jeehong/glow-tube-clock/datasheet/辉光管显示在八字节示意图.jpg

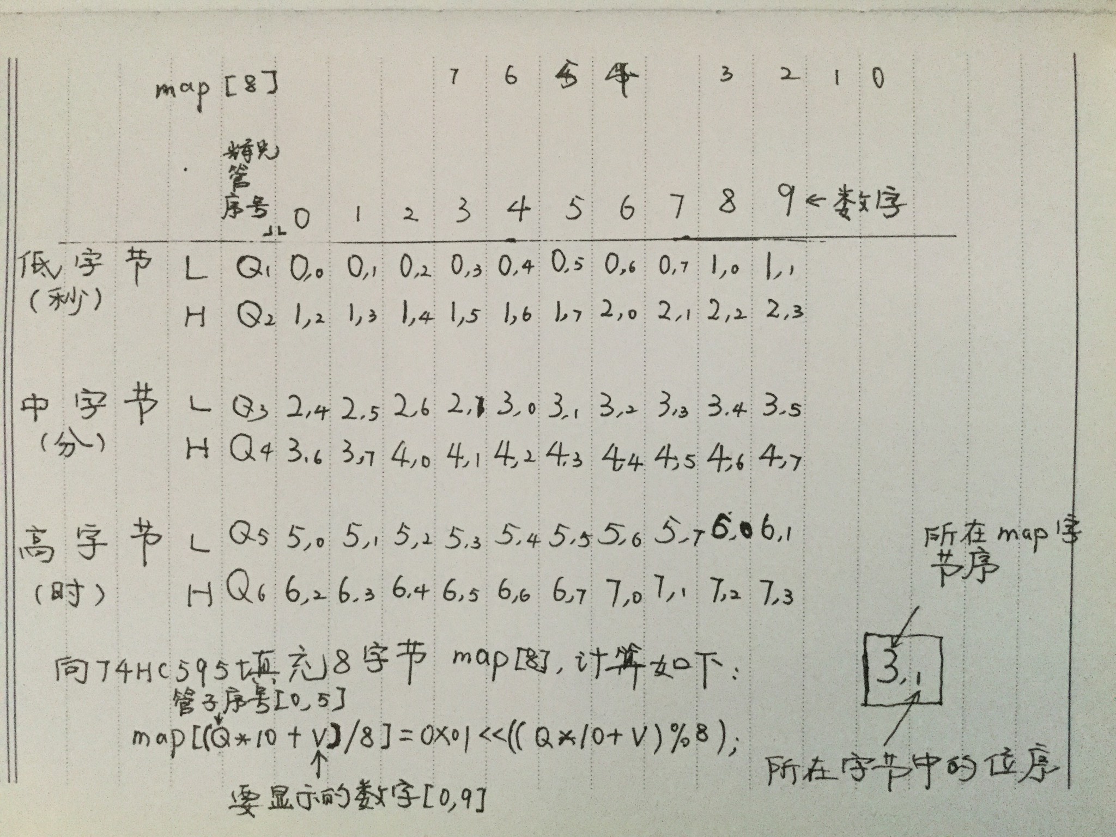
datasheet/辉光管显示在八字节示意图.jpg
