jeehong/glow-tube-clock/datasheet/in4.jpg

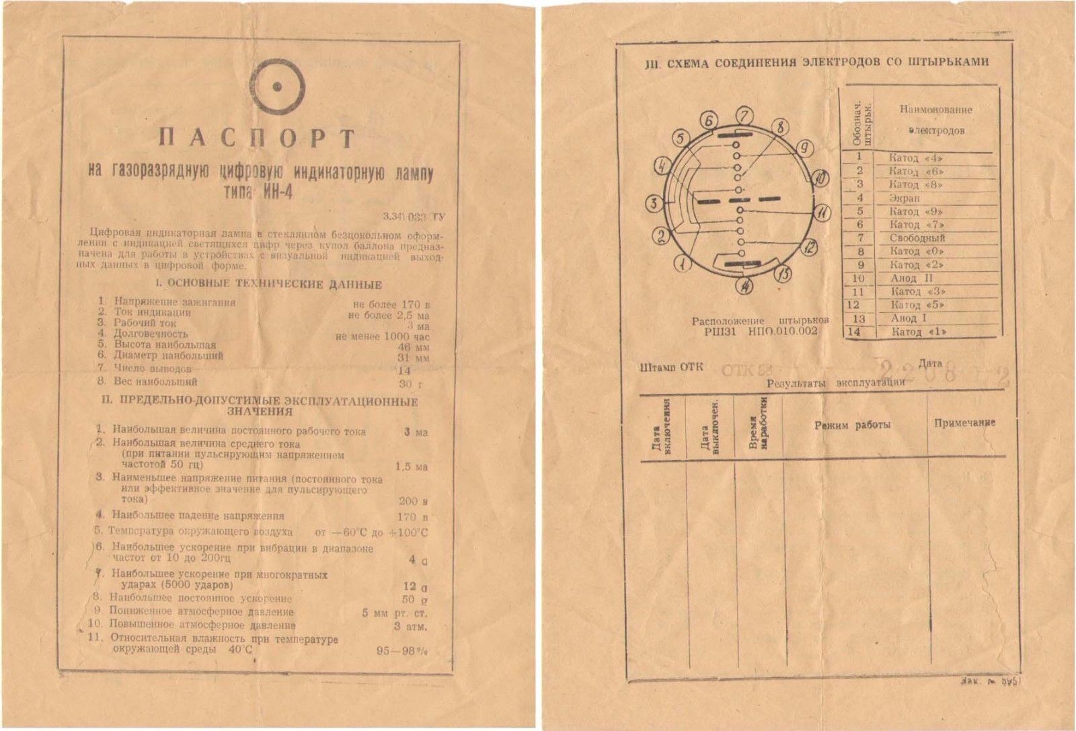
datasheet/in4.jpg
