jeehong/glow-tube-clock/README.md

----------
# **辉光管实时时钟** #

## 介绍 ##
 <p>辉光管亦称“冷阴极离子管”或“冷阴极充电管”，利用气体辉光放电原理而工作的离子管。。玻璃管中包括一个金属丝网制成的阳极和多个阴极。大部分数码管阴极的形状为数字。管中充以低压气体，通常大部分为氖加上一些汞和／或氩。给某一个阴极充电，数码管就会发出颜色光，视乎管内的气体而定，一般都是橙色或绿色。</p>
 <p>此次的diy项目就是利用辉光管的数显效果来做的，CPU采用STM32F103RCT6、软件搭载FreeRTOS实时系统、暂定使用LwIP协议栈，功能暂定温湿度显示日月年时分秒显示，网络校时网络获取当前温湿度的主体功能后续再考虑其他更有趣的功能。</p>

## 目录结构 ##
- datasheet:存放了器件原理图、构造、封装图等开发资料
- hardware:硬件工程，包含了原理图PCB图，器件原理图库、封装库
- software:软件工程，基于FreeRTOS、LwIP网络协议栈等

## 硬件 ##
- 开发环境：Altium Designer10
- STM32F103RCT6、DM9000、SHT10、DS3231SN、...

## 软件 ##
- 开发环境：Keil5
- 操作系统：FreeRTOS
- 网络协议栈：LwIP

## 项目进展 ##
请跳转至个人博客：[Jeehong's blog](https://jeehong.github.io/blog/2016/04/project-glow-tube-clock.html)

----------
