jeehong/glow-tube-clock/datasheet/in-4.jpg

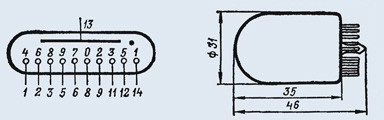
datasheet/in-4.jpg
