jeehong/glow-tube-clock/(threads)

Thread 1 (2018-11-09):

当前原理图下，存在几个已知的问题：

jeehong, 2018-11-09:
1、蜂鸣器不响问题：该问题实际电路制作时将PA12（原电路）与相邻的PA11(PWM)短接，软件上将PA12设置为输入模式，利用PA11的PWM功能模拟驱动蜂鸣器；
2、驱动辉光管的三极管为8050无法正常驱动，实际电路制作使用的9013；
3、目前为止，以太网功能没有调通；
4、高压驱动电路存在问题，实际电路制作购买的网上成熟的升压电路模块；
备注：
* 关于问题1、2会更新到github。
* 问题3找了好久问题，最后也没定位是硬件还是软件问题。我有一块类似的工程板（运行良好），软硬件都是基于此参考设计，硬件选型和布板差异，所以我比较倾向硬件出现问题。
* 问题4因为整个升压电路设计存在较大问题，我在组装的时候直接留空了这部分电路，取代的是外部扩展的升压电路模块。
* 还想说的是辉光管管脚不沾锡的问题，很苦恼，因为过一段时间就会出现几个数字无故不显示（可能因为热胀冷缩），最后到网上买了一瓶助焊剂”助焊剂 约25ML 轻松焊接不锈钢 铜铁 镀锌板“，效果很好。

jeehong, 2018-11-17:
非常高兴，今天把问题3关于以太网不通的问题解决了，稍后我会把代码提交到服务器上。

jeehong, 2018-11-17:
commit 4cc5905118978759937c8da403f1094f148c4fc3

jeehong, 2018-11-17:
具体网络信息配置在app/netconfig.c文件中

KnightChen2019, 2020-11-19:
请问可以用在IN8上吗？
