jeehong/glow-tube-clock/(list of files, drawings)

Other design files:
hardware/PCB.PcbDoc
hardware/PCB_Project.PrjPCB
hardware/PcbLib_IC.PcbLib
hardware/Schlib_IC.SchLib
hardware/Sheet.SchDoc
