jeehong/glow-tube-clock/software/src/app/app_display.c

#include "string.h"

#include "os_inc.h"

#include "app_inc.h"

#include "bsp.h"

#define	 	TUBE_NUM		6
#define		CHIP595_NUM		8

static void app_display_write_byte(U8 data);
static void app_display_show_data(void);
static void app_display_write_data(const U8 *pdata);
static void app_display_calc_map(U8 *desc, const U8 *src);
static void app_display_set_point(U8 src);
static void app_display_set_hv(SWITCH_STATE_e state);

/*
 * 实际测试1us
 */
static void delay50ns(void)
{
	U8 ns = 10;
	
	while(ns--) ;
}

/* 将一个字节传输至锁存器 */
static void app_display_write_byte(U8 data)
{  
	U8 index;
	
	for(index = 0; index < CHIP595_NUM; index++) 
	{
	    bsp_74hc595_set_SH_CP(Bit_RESET);
		if((data << index) & 0x80) 
			bsp_74hc595_set_DATA(Bit_SET);
		else 
			bsp_74hc595_set_DATA(Bit_RESET);
		delay50ns();	
		bsp_74hc595_set_SH_CP(Bit_SET);
		delay50ns();
	}
}

/* 将传入的数据使能到输出管脚 */
static void app_display_show_data(void)
{
	bsp_74hc595_set_ST_CP(Bit_SET);	
	delay50ns();
	bsp_74hc595_set_ST_CP(Bit_RESET);
}

static void app_display_write_data(const U8 *pdata)
{
	U8 index;

	taskENTER_CRITICAL();
	for(index = CHIP595_NUM; index > 0; index--)
		app_display_write_byte(pdata[index - 1]);

	app_display_show_data();
	taskEXIT_CRITICAL();
}

/*
 * desc:指向向锁存器输入的8字节
 * src:指向待显示的6个辉光管数字[0,9],当超出给定范围时，认定为不显示任何内容
 * 小时高 小时低 分钟高 分钟低  秒高   秒低
 * src[0] src[1] src[2] src[3] src[4] src[5]
 */
static void app_display_calc_map(U8 *desc, const U8 *src)
{
	U8 tube;		/* 当前操作的管子序号 */
	const U8 tube_num = TUBE_NUM - 1;	/* 管子总数 */
	U8 calc;

	memset(desc, 0, CHIP595_NUM);
	for(tube = 0; tube <= tube_num; tube++)
	{
		if((U8)src[tube] <= 9)
		{
			calc = tube * 10 + src[tube_num - tube];
			desc[calc >> 3] |= 0x01 << (calc % 8);
		}
		else		/* 当满足这个条件时，则默认为不显示任何内容 */
		{}
	}
}

/*
 * src:指向待显示的亮点类型
 * 高四位    *    *    ·  ·  高位冒号
 *         0 *  1 · 2 * 3 · 
 *
 * 低四位    *    *    ·  ·  低位冒号
 *         0 *  1 · 2 * 3 · 
 * ※表示不显示
 */
static void app_display_set_point(U8 src)
{
	switch(src >> 4)
	{
		case 0:
			POINT_LBOT_PIN_GROUP->BRR = POINT_LBOT_PIN;
			POINT_LTOP_PIN_GROUP->BRR = POINT_LTOP_PIN;
			break;
		case 1:
			POINT_LBOT_PIN_GROUP->BSRR = POINT_LBOT_PIN;
			POINT_LTOP_PIN_GROUP->BRR = POINT_LTOP_PIN;
			break;
		case 2:
			POINT_LTOP_PIN_GROUP->BSRR = POINT_LTOP_PIN;
			POINT_LBOT_PIN_GROUP->BRR = POINT_LBOT_PIN;
			break;
		case 3:
			POINT_LBOT_PIN_GROUP->BSRR = POINT_LBOT_PIN;
			POINT_LTOP_PIN_GROUP->BSRR = POINT_LTOP_PIN;	
			break;
		default: 
			break;
	}	
	switch(src & 0x0f)
	{
		case 0:
			POINT_RBOT_PIN_GROUP->BRR = POINT_RBOT_PIN;
			POINT_RTOP_PIN_GROUP->BRR = POINT_RTOP_PIN;
			break;
		case 1:
			POINT_RBOT_PIN_GROUP->BSRR = POINT_RBOT_PIN;
			POINT_RTOP_PIN_GROUP->BRR = POINT_RTOP_PIN;
			break;
		case 2:
			POINT_RTOP_PIN_GROUP->BSRR = POINT_RTOP_PIN;
			POINT_RBOT_PIN_GROUP->BRR = POINT_RBOT_PIN;
			break;
		case 3:
			POINT_RTOP_PIN_GROUP->BSRR = POINT_RTOP_PIN;
			POINT_RBOT_PIN_GROUP->BSRR = POINT_RBOT_PIN;	
			break;
		default: 
			break;
	}	
}	


static U8 lcd_pixel[7];
static SWITCH_STATE_e hv_state = ON;
static U8 processing = TRUE;

void app_display_task(void *parame)
{
	U8 map[CHIP595_NUM] = {10};
	U8 state = 0;
	U8 start_dis = 0;

	while(1)
	{
		switch (state)
		{
			case 0:
				if(hv_state == ON)
				{
					bsp_set_hv_state(ON);
					app_display_set_show(Bit_SET);
					vTaskResume(main_get_task_handle(TASK_HANDLE_LED));
					start_dis = 0;
					state = 1;
				}
				break;
			case 1:
				start_dis ++;
				if(start_dis >= 10)
					state = 2;
				processing = TRUE;		/* start protecting lcd_pixel */
				memset(lcd_pixel, start_dis % 10, 6);
				/* go on */
			case 2:
				processing = TRUE;		/* start protecting lcd_pixel */
				if(hv_state == OFF)
				{
					memset(lcd_pixel, 0, 6);
					state = 3;
				}
				app_display_set_point(lcd_pixel[6]);
				app_display_calc_map(map, lcd_pixel);
				processing = FALSE;
				app_display_write_data(map);
				if(state == 1)
					vTaskDelay(mainDELAY_MS(600));
				else
					vTaskDelay(mainDELAY_MS(100));
				break;
			case 3:
				bsp_set_hv_state(OFF);
				app_display_set_show(Bit_RESET);
				GPIO_ResetBits(LED_PIN_GROUP, LED_PIN_R | LED_PIN_G | LED_PIN_B);
				vTaskSuspend(main_get_task_handle(TASK_HANDLE_LED));
				vTaskSuspend(main_get_task_handle(TASK_HANDLE_DISPLAY));
				state = 0;
				break;
			default:
				break;
		}
	}	
}

void app_display_show_info(U8 *src)
{
	if(processing == TRUE)
		return;
	taskENTER_CRITICAL();
	memcpy(lcd_pixel, src, 7);
	taskEXIT_CRITICAL();
}

static void app_display_set_hv(SWITCH_STATE_e state)
{
	hv_state = state;
}

void app_display_on(rtc_time_attribute *tm)
{
	app_display_set_hv(ON);
	vTaskResume(main_get_task_handle(TASK_HANDLE_DISPLAY));
}

void app_display_off(rtc_time_attribute *tm)
{
	app_display_set_hv(OFF);
}
