jeehong/glow-tube-clock/software/src/mid/mid_th.c

#include "mid_th.h"

ERROR_CODE mid_th_get_data(struct _mid_th_data_t *p)
{
	ERROR_CODE err = STATUS_NORMAL;
	struct _mid_th_data_t dt;

	if(p == NULL)
	{
		err = ERR_POINTER_0;
	}
	if(err == STATUS_NORMAL)
	{
		dt.temperature = hal_sht10_get_data(TEMP);
		if(dt.temperature < 0)
		{
			err = ERR_TMOUT;
		}
	}
	if(err == STATUS_NORMAL)
	{
		dt.humidity = hal_sht10_get_data(HUM);
		if(dt.humidity < 0)
		{
			err = ERR_TMOUT;
		}
		memcpy(p, &dt, sizeof(struct _mid_th_data_t));
	}
	return err;
}
