jeehong/glow-tube-clock/software/src/app/app_inc.h

#ifndef __APP_INC_H__
#define __APP_INC_H__

#include "app_time.h"
#include "app_th.h"
#include "app_display.h"
#include "app_led.h"
#include "app_cli.h"
#include "app_buz.h"
#include "app_data.h"
#include "app_led.h"
#include "netconfig.h"

#include "main.h"

#endif
