jeehong/glow-tube-clock/(commit log)

2016-04-21 添加部分原理图 器件原理图
2016-04-21 更新 README.md
2016-04-21 更新02 README.md
2016-04-21 更新03 README.md
2016-04-21 添加时钟芯片和pmos管datasheet
2016-04-21 创建硬件工程，添加LM2596 datasheet
    [PCB_Project.PrjPCB, PcbLib_IC.PcbLib, Schlib_IC.SchLib, Sheet.SchDoc]
2016-04-22 更新原理图
    [PcbLib_IC.PcbLib, Schlib_IC.SchLib, Sheet.SchDoc]
2016-04-22 硬件原理图添加了作为冒号用的氖泡灯管
    [Sheet.SchDoc]
2016-04-25 修改README.md
2016-04-25 上传部分器件datasheet；更新原理图，更新器件库
    [PcbLib_IC.PcbLib, Sheet.SchDoc]
2016-04-26 创建软件工程，移植了FreeRTOS系统；更新硬件原理图
    [PCB.PcbDoc, PcbLib_IC.PcbLib, Sheet.SchDoc]
2016-04-26 硬件原理图添加6个背景LED，修复部分封装不匹配的问题
    [PCB.PcbDoc, PcbLib_IC.PcbLib, Sheet.SchDoc]
2016-04-27 引入LwIP网络协议栈，编译通过，等待测试
2016-04-27 规范LwIP文件include "folderpath/filename.h"
2016-04-27 添加了一个线程任务，提供一个简单的网页服务
2016-04-27 修改网络初始化位置
2016-04-27 修改README.md；修改sofware目录名为software
2016-04-27 修改注释的格式
2016-04-28 修复部分内容
2016-04-29 修改网络任务，未成功
2016-05-02 调试网络2016/5/3
2016-05-04 修改硬件原理图关于DM9000的控制接口；调试LwIP，2016/5/4
    [PCB.PcbDoc, PcbLib_IC.PcbLib, Schlib_IC.SchLib, Sheet.SchDoc]
2016-05-04 更新PCB布局，修正IN-4封装为俯视
    [PCB.PcbDoc, PcbLib_IC.PcbLib, Sheet.SchDoc]
2016-05-05 布板5/6 0:40
    [PCB.PcbDoc, Sheet.SchDoc]
2016-05-06 LwIP功能调试成功，打开网页172.10.11.110可获取欢迎网页
2016-05-06 led任务添加方式采用系统函数
2016-05-07 修改格式
2016-05-07 PCB初步完成布线，等待修正部分电路电气特性和布局优化
    [PCB.PcbDoc, Sheet.SchDoc]
2016-05-08 修复硬件版图中辉光管需要X镜像的错误；修复部分地线孤岛的问题
    [PCB.PcbDoc, PcbLib_IC.PcbLib]
2016-05-08 硬件原理图添加项目名称
    [Sheet.SchDoc]
2016-05-08 修改设备ip地址为192.168.1.156
2016-05-08 微调pcb
    [PCB.PcbDoc]
2016-05-09 根据pcb厂家修改布线规则，线距为7mil；修改原理图中bezzer的三极管接线
    [PCB.PcbDoc, Sheet.SchDoc]
2016-05-09 1.检查原理图并修复一些错误; 2.PCB新增四个螺丝孔，重新定义板子形状;
    [PCB.PcbDoc, Sheet.SchDoc]
2016-05-10 修复硬件关于高压输出控制电路的设计
    [PCB.PcbDoc, Sheet.SchDoc]
2016-05-10 添加datasheet:RJ-45;优化器件库封装，优化PCB布局
    [PCB.PcbDoc, PCB_Project.PrjPCB, PcbLib_IC.PcbLib, Sheet.SchDoc]
2016-05-15 datasheet文件夹:添加《FreeRTOS入门手册》
2016-05-15 1.datasheet文件夹：添加《STM32固件库V3.5.0使用》
2016-05-18 新增串口调试输出功能:dbg_string(const char *fmt, ...);
2016-05-18 删除串口自动发送任务
2016-05-19 删除关于mcu时基初始化无关的操作
2016-05-19 添加RGB led灯任务
2016-05-20 模拟i2c通讯，该bsp代码可用于多路i2c硬件选择通信
2016-05-20 i2c_bus:填充us级延时函数功能
2016-05-20 添加辉光管电源控制功能：硬件初始化；状态控制；状态读取
2016-05-21 新增app_display功能
2016-05-22 修复bsp.c中一个函数命名错误
2016-05-22 优化app_display功能
2016-05-22 添加了辉光管显示任务，添加了一个用于多任务输出显示内容的队列，在app_led提供的任务中有示例
2016-05-23 添加对两个冒号的控制
2016-05-24 1.添加对两个冒号的测试功能； 2.当需要输出显示时，改用只有拿到互斥量，才有资格对显示内容做修改。
2016-05-24 两个冒号显示效果接口函数引用宏而非底层，便于移植
2016-05-26 修复了关于互斥量内存出错的bug
2016-05-26 关闭高压输出功能，硬件调试通过后再打开
2016-05-29 新增sht10功能，待测试
2016-05-29 1、sht10:修复i2c总线通讯错误，测试通过温湿度传感器功能； 2.datasheet/：添加文件sht10温湿度传感器说明书。
2016-05-29 添加ds3231功能，待测试
2016-05-29 i2c_bus.c:重新设计api接口，使其通用性增强
2016-05-29 优化测试例程
2016-05-30 测试通过ds3231读写RTC功能
2016-05-31 1.新增ds3231器件定时功能api:定时使能设置，定时信息设置，定时状态读取； 2.新增ds3231闹钟功能，并启用外部中断+信号量，用于同步当前时间，具体见文件app_ds3231.c；
2016-06-03 优化部分内容
2016-06-04 添加蜂鸣器报警任务
2016-06-04 更新闹钟为整点蜂鸣，蜂鸣次数跟随当前小时
2016-06-08 调试74HC595
2016-06-10 测试辉光管功能，调试未完成
2016-06-10 测试75HC595
2016-06-13 修改文件app_display.c中部分函数命名
2016-06-13 调试通过app_display.c功能；新增显示当前时间功能
2016-06-15 修改硬件原理图中控制辉光管通断三极管型号为A42
    [Sheet.SchDoc]
2016-06-15 区分了显示时间和显示温湿度的显示时间，二者根据时间切换显示
2016-06-15 测试功能
2016-06-15 修复了描述display资源信号量被抱死的bug
2016-06-18 修复数字变化时部分数字不显示的bug，优化显示内容
2016-06-18 修改温湿度显示时，湿度为0.xx
2016-06-19 修改sht10循环任务周期500ms，删除sht10和ds3231串口打印信息
2016-06-20 修复上电时三色LED闪烁效果常亮问题
2016-06-21 添加功能：在19:30-23:30之外时，高压不输出
2016-06-21 优化定时显示功能，加入了LED挂起和恢复
2016-06-22 首次当上电时，在当天定时的关闭显示时间之前均点亮辉光管
2016-06-24 修改辉光管、三色LED、蜂鸣器工作时间为7:50~23:00
2016-06-28 修改辉光管工作时间 7:50~8:40 20:30~23:00
2016-08-09 优化部分变量的类型，优化部分函数的入参类型
2016-08-17 修改部分宏和类型至.c中
2016-10-17 删除关于网络的功能，修改了sht10在空闲时停止转换的功能
2016-10-22 增加串口命令行工具，支持的命令:help,hi,info,clear,date,sdate,th,led,reboot.
2016-10-22 提升了display,led命令的稳定性，对于不符合输入规则的直接忽略
2016-10-23 新增task命令，该命令列出了所有任务优先级堆栈使用情况，以及当前运行状态
2016-10-23 删除部分冗余代码和注释
2016-11-27 新增命令showtime，可以设置定时开启时间显示和led，具体使用方法执行help命令查看
2016-11-30 app_data：添加存储任务，新增了非易失存储功能，当前存储了定时显示功能。
2017-02-04 CLI: 重新规划命令行功能
2017-02-11 新增命令行接受串口数据信号量机制，以节省CPU资源
2017-06-16 更新命令行结构
2017-06-29 删除全局的结构体，以面向对象的思想构建每个模块。
2017-07-01 在写显示数据时增加互斥特性，避免数据处理后写入前被修改
2017-07-02 命令th可立刻返回温湿度数据
2017-07-02 1）修复命令sdate总是设置失败的bug； 2）led命令增加一个参数，可以选择R/G/B显示，详细操作执行help查询；
2017-07-02 main.h新增软件版本号
2017-07-02 修复sdate总是无效的问题
2017-08-04 优化了命令行，提高处理效率
2017-08-04 修改默认的命令行前缀为Terminal
2017-08-17 修改了sht10的温度湿度算法，优化ds3231定时任务运行方式
2017-08-18 更新ds3231
2017-08-20 优化ds3231任务结构
2017-08-21 修复早上0700-0840定时功能初始化错误的问题
2017-08-27 优化app_display_task任务，改为状态机实现
2017-08-27 v1.3.0:更新整个代码目录，代码结构做了分层：hal/mid/app层
2017-08-27 修复命令info打印格式出错的问题
2017-08-28 删除hal_uart.c中接收数据信号量
2017-09-03 help命令打印信息加延时，缓解打印函数的压力；修复温湿度显示时偶尔显示全0的问题。
2017-12-29 1）修复了无限次数蜂鸣的bug； 2）修复了命令行sdate设置时间时，返回格式错误的问题； 3）硬件上修复无法触发蜂鸣的问题：原因在于硬件上需要将PA11&PA12短接；
2017-12-30 新增存储当前设置的LED颜色，优化存储
2018-01-07 增加kalman滤波工具，调试温度通过卡尔曼滤波输出
2018-01-20 优化命令行
2018-04-17 修改部分参数和函数命名
2018-11-17 update software version to 2.0.0 1.Update project files of hardware about buzzer control port,detial:PA12->PA11; 2.Network(LwIP) function is supported; 3.Network funciton test cases were pass;
    [PCB.PcbDoc, Sheet.SchDoc]
2019-03-29 调整了dm9000.c格式
2019-04-16 1.修复app_cli.c帮助信息错误； 2.修复mid_rtc有效性返回错误； 3.新增了socket TCP服务器，仅仅是测试，为移植mqtt客户端做准备。
    [app_cli.c, app_th.c, app_time.c, dm9000x.c, main.c]
