jeehong/glow-tube-clock/(notices)

Notices in the files:
software/src/Lwip-1.3.2/src/include/lwip/opt.h:
Copyright (c) 2001-2004 Swedish Institute of Computer Science.
All rights reserved.
